YnotZer0/ACPCPE/ACPCPE_v2.jpg

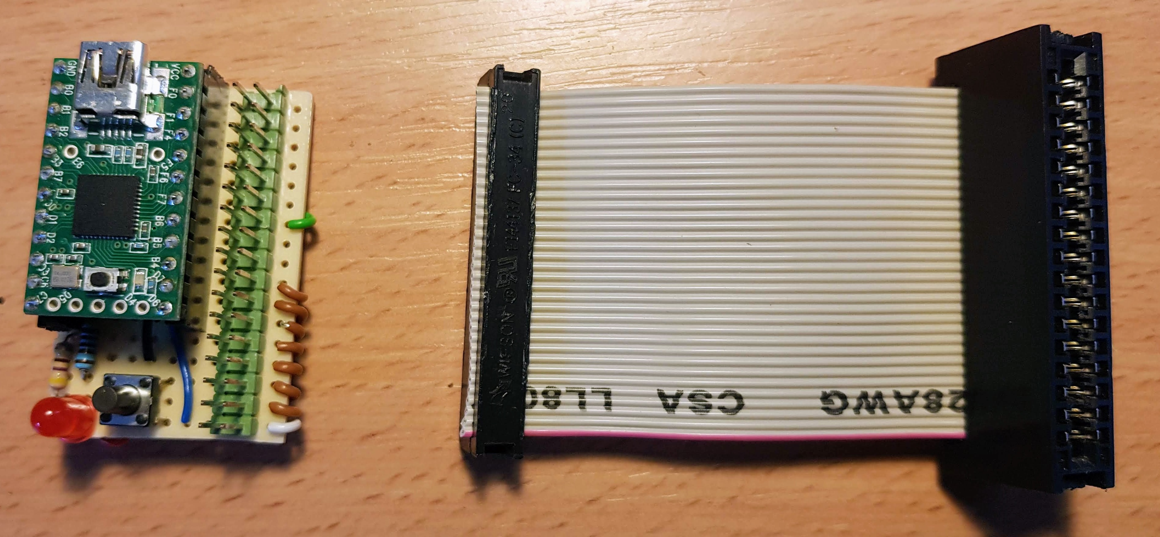
ACPCPE_v2.jpg
