YnotZer0/ACPCPE/(commit log)

2019-08-18 Simplified 1 button circuit
2019-08-23 Photo of finished prototype
2019-08-23 Added schematics to README.md
2019-08-31 Replaced NE555 for software debouncing
    [ACPCPE.ino, ACPCPE.py]
2022-07-28 Added extra technical info to the README.md
    After studying the Amstrad CPC's schematics, I think I can tell why the Printer port is only 7-bit, so I added my explanation to the README.md
2023-10-07 Update ACPCPE.ino
    added debugs for debugging before listening from python. allowed me to review in arduino IDE serial monitor what was being passed back and forth
2023-10-07 photo of working TP device
    before visiting PCBway to make some proper boards
2023-10-08 Update ACPCPE.ino
    figured out the double output. it was due to the /STROBE interrupt being called twice (obviously), changed from triggering it on LOW to CHANGE and within function for reading only processed if it was LOW. Tested from Arduino debug - works a treat. Tested from Python code. works a treat.
2023-10-08 added test ouput
    this is the result of on a 6128, load"copycat.bas", followed by a list#8. This is what is sent to the PC, received by the python code and output to a file. As you can see, it is the listing of the BASIC code that in itself actually outputs a CAT of the DISC in the floppy drive to the printer - so yes, running this BASIC code also sends this output to the PC if you run the program. awesomeness, all round!
2023-10-15 schematic with oled
    first draft of schematic to go with .ino code
2023-10-15 Update README.md
    added OLED schematic
